aesirkth/atlas_load_cell/hardware/aesir_scale/USB4105-GF-A.step

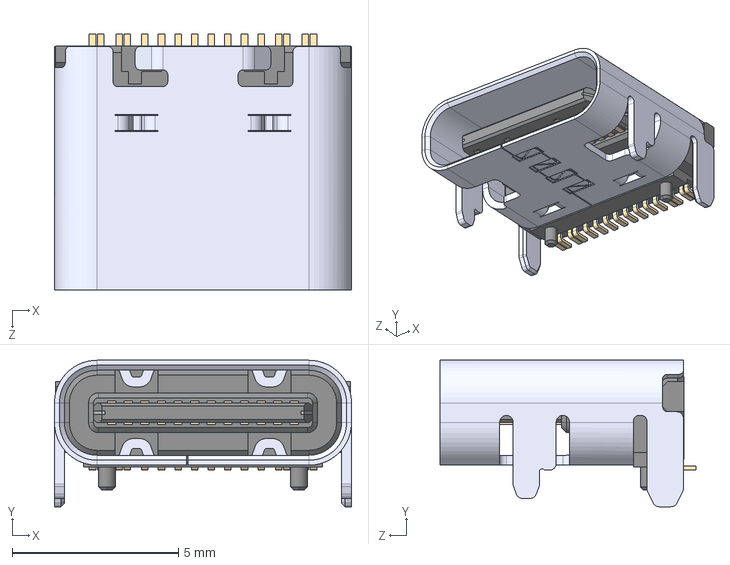
[picture p1: CAD file, 2025-03-17]
hardware/aesir_scale/USB4105-GF-A.step
8.94 x 4.41 x 7.71 mm
