aesirkth/atlas_load_cell/hardware/aesir_scale/aesir_scale.pdf

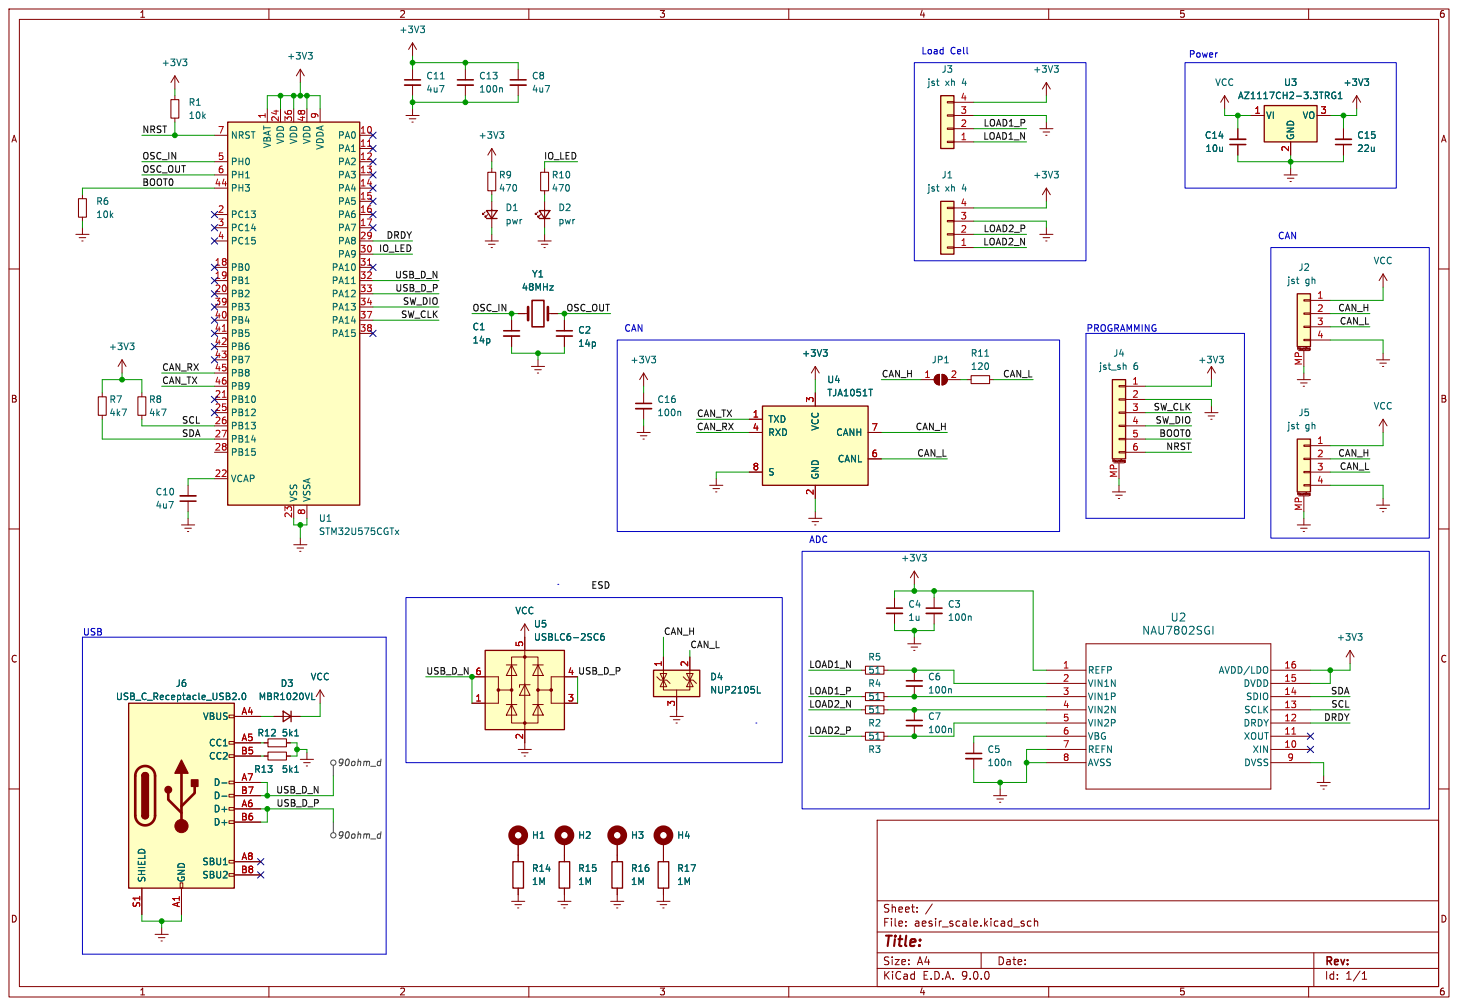
[picture p2: page 1]

1 VDD 24 VDD 36 VSS 23 VDD 48 VSSA

Id: 1/1 Title: File: aesir_scale.kicad_sch Sheet: /
