aesirkth/atlas_load_cell/(commit log)

2023-11-17 USB diode & CAN jumper
    [aesir_scale.kicad_pcb, aesir_scale.kicad_sch]
2023-11-20 add caps
    [aesir_scale.kicad_pcb, aesir_scale.kicad_sch]
2025-03-17 correct i2c bus
    [USB4105-GF-A.step, aesir_scale.kicad_pcb, aesir_scale.kicad_sch]
2025-04-04 cleanup and correct led name
    [main.c]
2025-10-31 integrated NAU7802 driver module in build
